SuoweiHu/ENGN1211-Maze-Solving-Rover/# Rover Code/Screen Shot 2021-05-14 at 5.12.15 pm.png

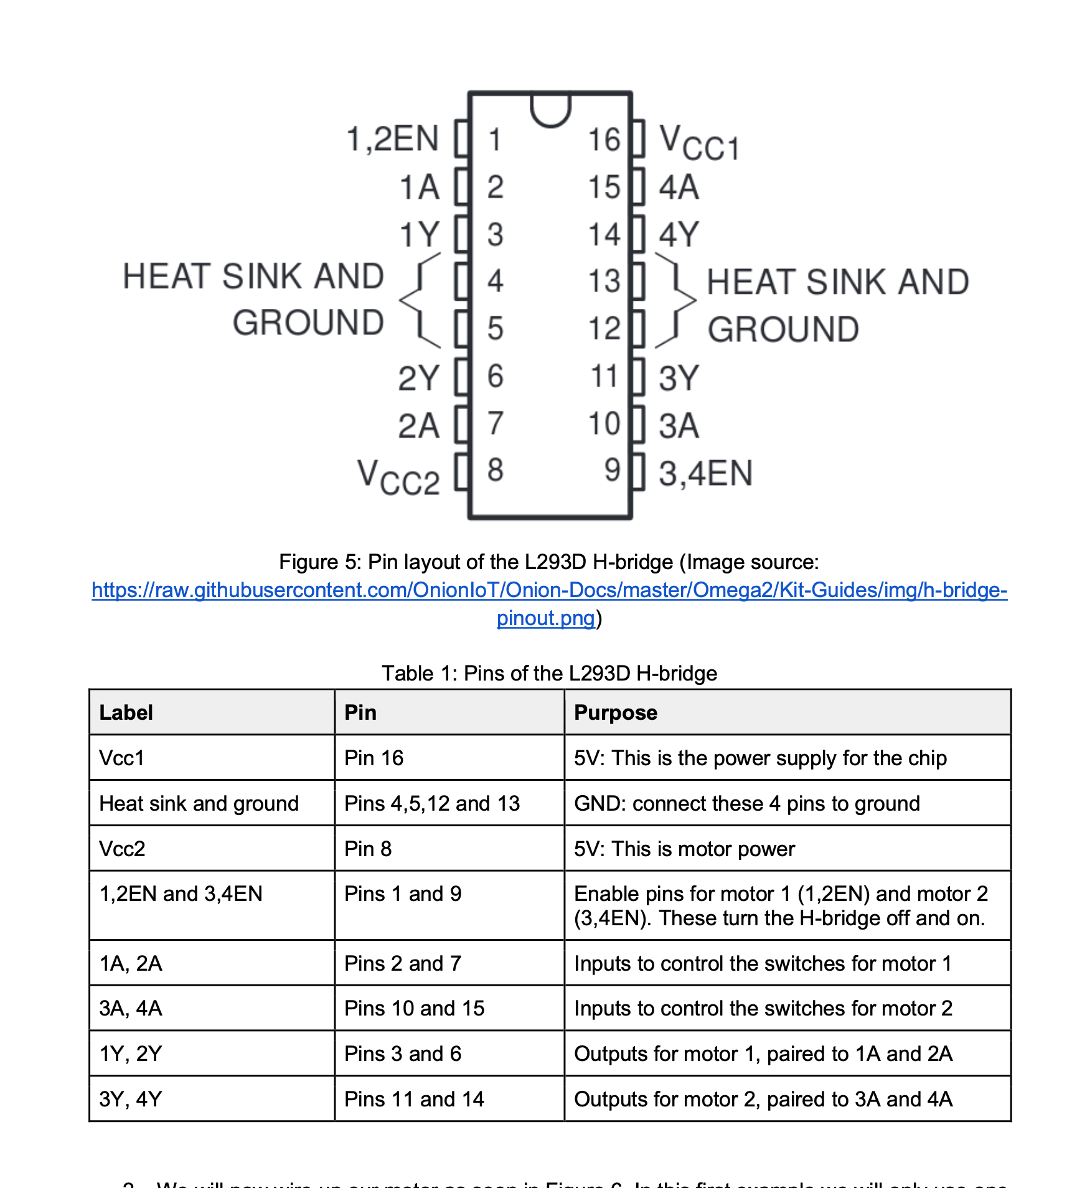
# Rover Code/Screen Shot 2021-05-14 at 5.12.15 pm.png
