SuoweiHu/ENGN1211-Maze-Solving-Rover/# Rover Code/Screen Shot 2021-05-14 at 11.22.32 am.png

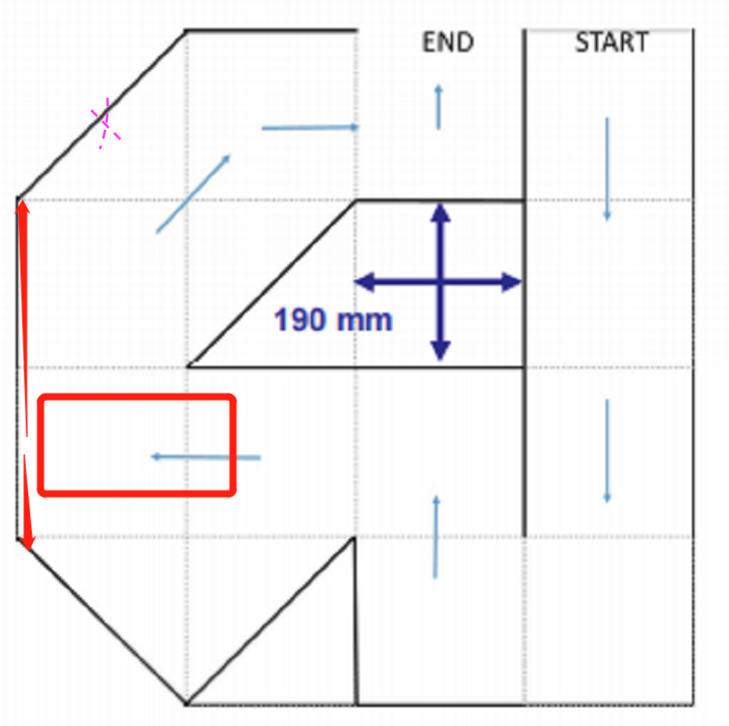
# Rover Code/Screen Shot 2021-05-14 at 11.22.32 am.png
