SuoweiHu/ENGN1211-Maze-Solving-Rover/# Rover Code/Screen Shot 2021-05-16 at 8.23.22 pm.png

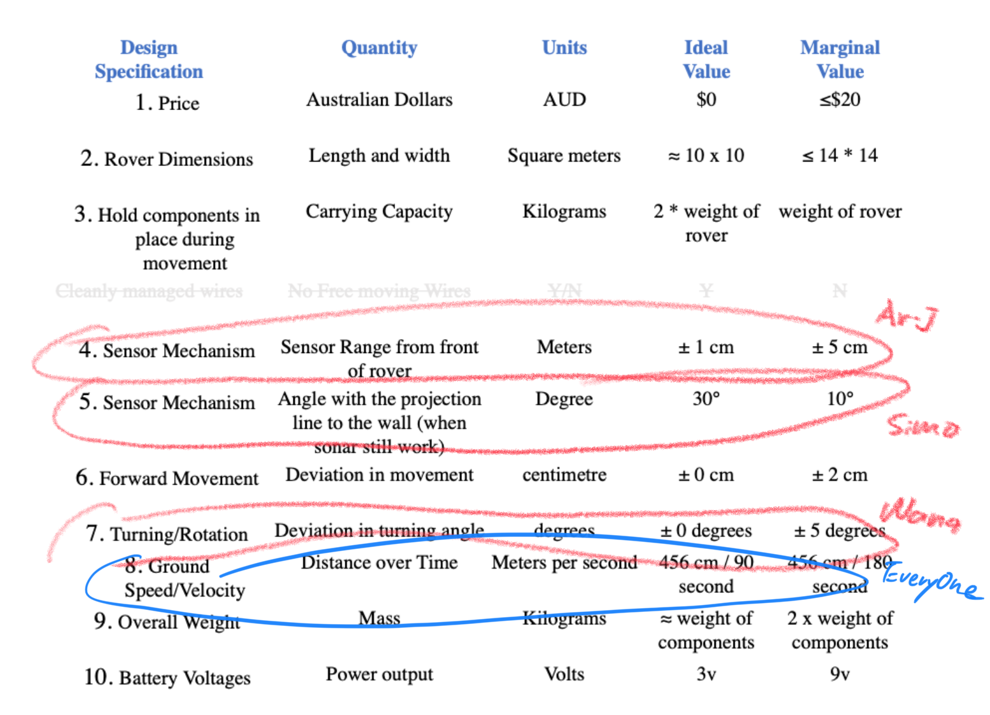
# Rover Code/Screen Shot 2021-05-16 at 8.23.22 pm.png
