SuoweiHu/ENGN1211-Maze-Solving-Rover/# Rover Code/2021.05.14_Rover/_config_pin.h

#define PIN_ECHO 12         // SONAR SENSOR - Echo Pin
#define PIN_TRIGGER 11      // SONAR SENSOR - Trigger Pin

#define PIN_SERVO 3         // SERVO MOTOR  - Signal Pin

#define PIN_A_MOTOR_L  8    // MOTOR L      - 1A Pin
#define PIN_B_MOTOR_L  10   // MOTOR L      - 2A Pin
#define PIN_EN_MOTOR_L 5    // MOTOR L      - EN Pin (Left Motor)

#define PIN_B_MOTOR_R 7     // MOTOR R      - 4A Pin
#define PIN_A_MOTOR_R 6     // MOTOR R      - 3A Pin
#define PIN_EN_MOTOR_R 9    // MOTOR R      - EN Pin (Right Motor) 
