SuoweiHu/ENGN1211-Maze-Solving-Rover/# Rover Code/2021.05.14_Rover/_config_motor.h

#define SM_RIGHT   0     // SERVO MOTOR - Right (Postion)
#define SM_MID_R  25     //             - Middle Right 
#define SM_CENTRE 75     //             - Centre
#define SM_MID_L 125     //             - Middle Left
#define SM_LEFT  180     //             - Left   

#define ML_SPEED 252     // MOTOR LEFT  - Proportion of full power 255
#define MR_SPEED 255     // MOTOR RIGHT - ... 
