SuoweiHu/ENGN1211-Maze-Solving-Rover/# Rover Code/2021.05.14_Rover/_config_timing.h

// If using seperate powering 
//#define L_TURN_DELAY_LEFT  665   // Time to wait when turning a l-turn (left)
//#define L_TURN_DELAY_RIGHT 665   // Time to wait when turning a l-turn (right)
//#define U_TURN_DELAY 1370         // Time to wait when turning a u-turn 
// #define L_TURN_DELAY_HALF_L 330
// #define L_TURN_DELAY_HALF_R 330

// If using one (9v) powering
#define L_TURN_DELAY_LEFT  950   // Time to wait when turning a l-turn (left)
#define L_TURN_DELAY_RIGHT 950   // Time to wait when turning a l-turn (right)
#define U_TURN_DELAY 1370         // Time to wait when turning a u-turn 
#define L_TURN_DELAY_HALF_L 450
#define L_TURN_DELAY_HALF_R 450
#define BACK_OFF 900
